mccolagan/colagan-pico-split-keyboard/hardware/images/usb-c-16p-brochage.png

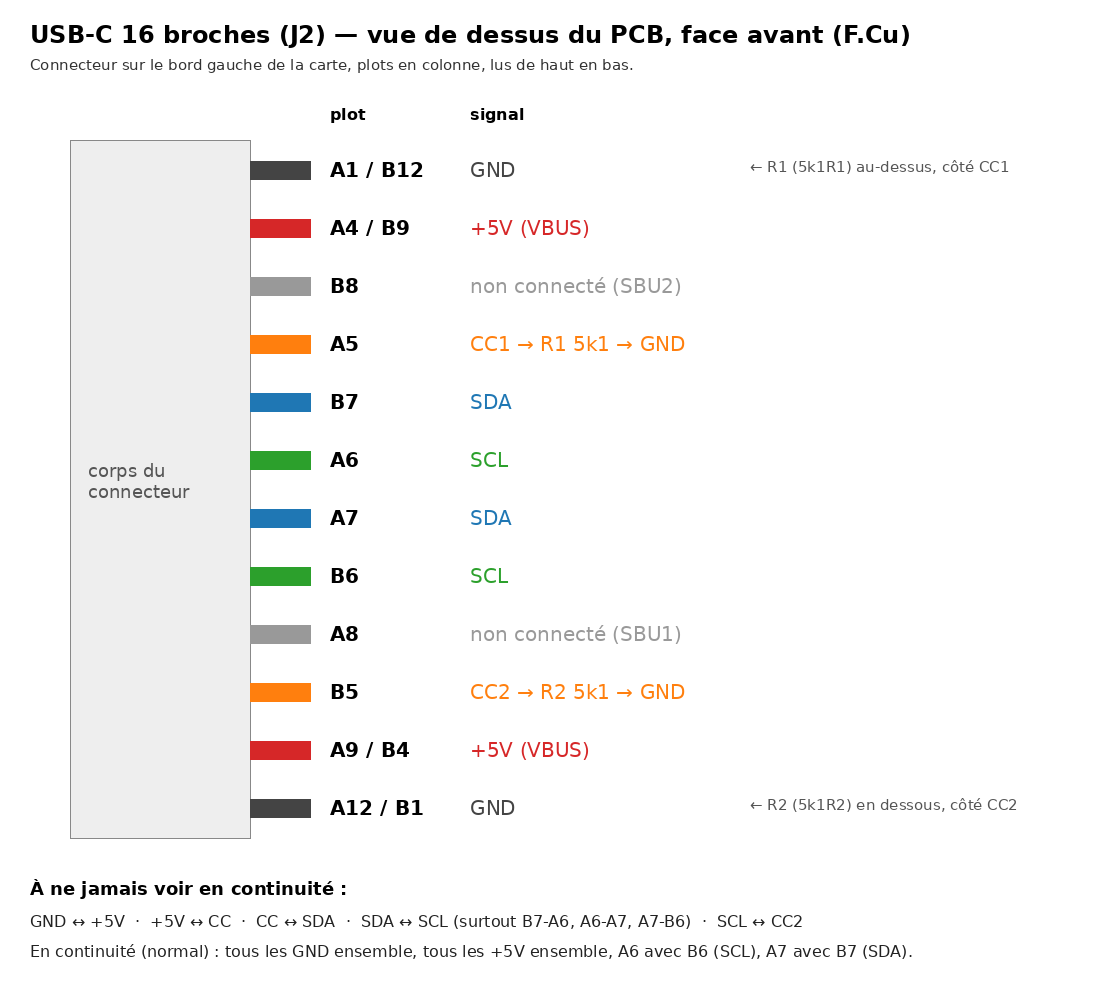
hardware/images/usb-c-16p-brochage.png
