mccolagan/colagan-pico-split-keyboard/hardware/3d/SPlitKeyBoardReversibleV1.step

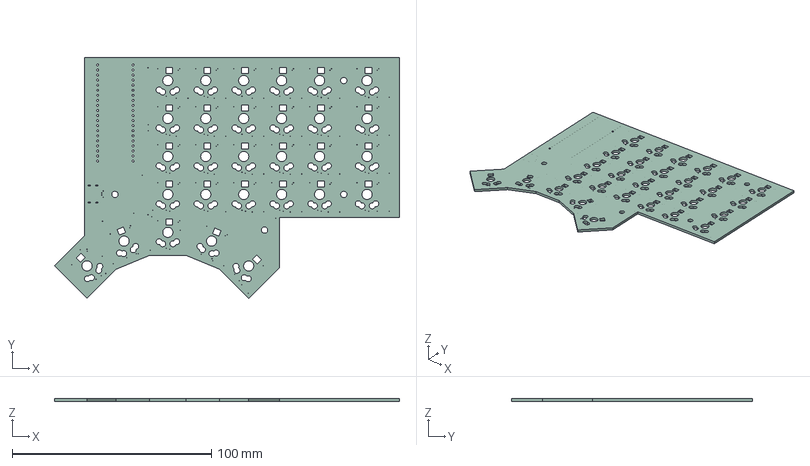
[picture p4: CAD file, 2026-10-23]
hardware/3d/SPlitKeyBoardReversibleV1.step
173.2 x 120.8 x 1.51 mm
