mccolagan/colagan-pico-split-keyboard/(list of files, cad)

Other CAD files:
hardware/3d/SPlitKeyBoardReversibleV1.3mf
