mccolagan/colagan-pico-split-keyboard/hardware/kicad/SplitKeyboard Colagan V2.kicad_pcb

## KiCad design hardware/kicad/SplitKeyboard Colagan V2.kicad_pcb (2026-10-25)

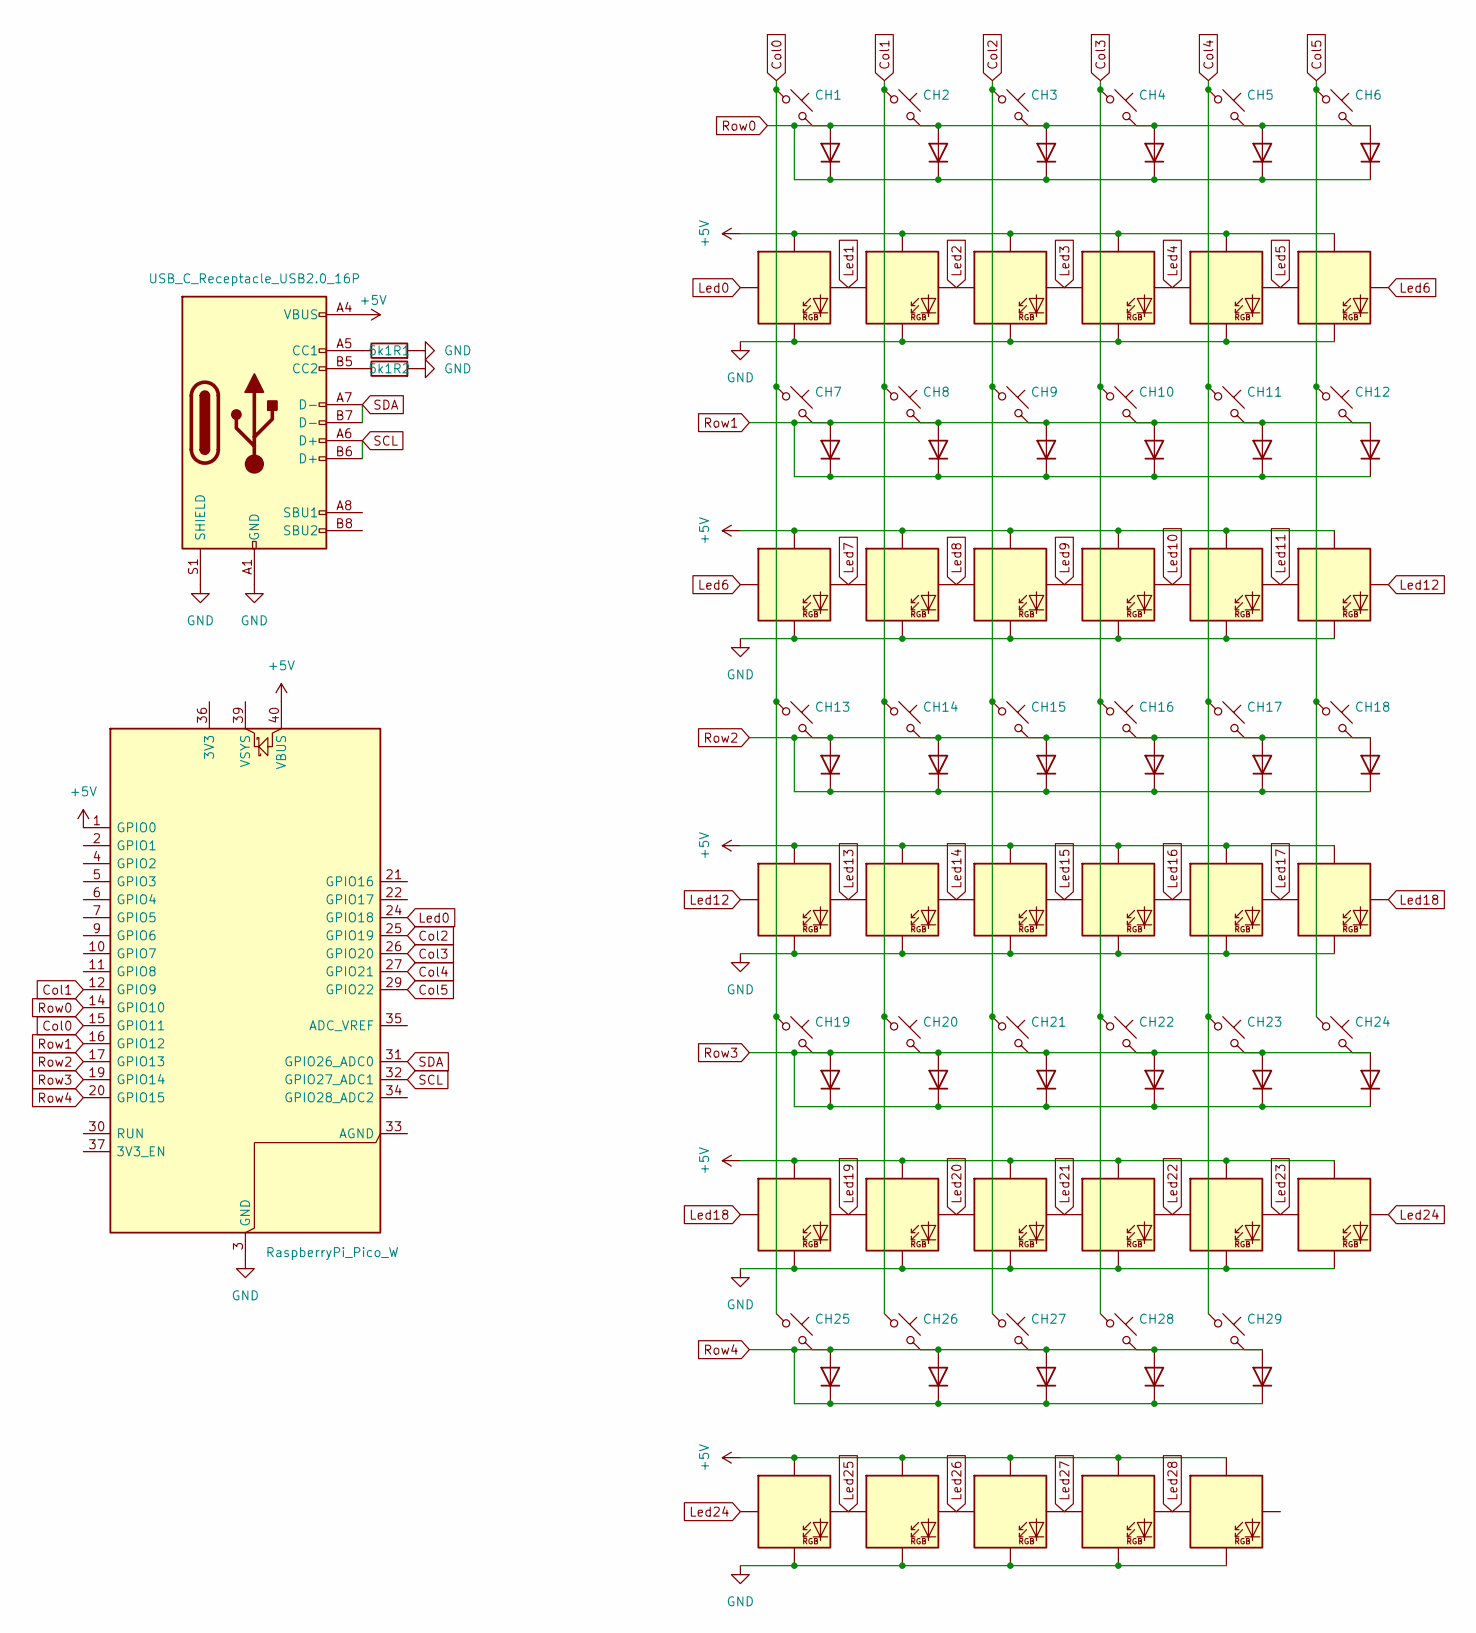
[picture p5: schematic SplitKeyboard Colagan V2.kicad_sch]

Parts:
5k1R1: R1; Capasitor_SMD_1206_Reversible_ColaganV3
5k1R2: Capasitor_SMD_1206_Reversible_ColaganV3
A1: RaspberryPi_Pico_W; RaspberryPi_Pico_Colagan_REF3
CH1, CH2, CH3, CH4, CH5, CH7, CH8, CH9, CH10, CH11, CH13, CH14, CH15, CH16, CH17, CH19, CH20, CH21, CH22, CH23, CH25, CH26, CH27, CH28, CH29: KS33_SW_HS; KS33-HS-Colagan-1U-Final
CH6, CH12, CH18, CH24: KS33_SW_HS; KS33-HS-Colagan-1.5U-Final
J2: USB_C_Receptacle_USB2.0_16P; USB_C_16P-Reversible-colagan

Connections:
+5V: A1.1 (GPIO0), A1.40 (VBUS), CH1.4 (VDD), CH2.4 (VDD), CH3.4 (VDD), CH4.4 (VDD), CH5.4 (VDD), CH6.4 (VDD), CH7.4 (VDD), CH8.4 (VDD), CH9.4 (VDD), CH10.4 (VDD), CH11.4 (VDD), CH12.4 (VDD), CH13.4 (VDD), CH14.4 (VDD), CH15.4 (VDD), CH16.4 (VDD), CH17.4 (VDD), CH18.4 (VDD), CH19.4 (VDD), CH20.4 (VDD), CH21.4 (VDD), CH22.4 (VDD), CH23.4 (VDD), CH24.4 (VDD), CH25.4 (VDD), CH26.4 (VDD), CH27.4 (VDD), CH28.4 (VDD), CH29.4 (VDD), J2.A4 (VBUS), J2.A9 (VBUS), J2.B4 (VBUS), J2.B9 (VBUS)
Col0: A1.15 (GPIO11), CH1.1, CH7.1, CH13.1, CH19.1, CH25.1
Col1: A1.12 (GPIO9), CH2.1, CH8.1, CH14.1, CH20.1, CH26.1
Col2: A1.25 (GPIO19), CH3.1, CH9.1, CH15.1, CH21.1, CH27.1
Col3: A1.26 (GPIO20), CH4.1, CH10.1, CH16.1, CH22.1, CH28.1
Col4: A1.27 (GPIO21), CH5.1, CH11.1, CH17.1, CH23.1, CH29.1
Col5: A1.29 (GPIO22), CH6.1, CH12.1, CH18.1, CH24.1
GND: 5k1R1.2, 5k1R2.2, A1.3 (GND), A1.8 (GND), A1.13 (GND), A1.18 (GND), A1.23 (GND), A1.28 (GND), A1.38 (GND), CH1.6 (VSS), CH2.6 (VSS), CH3.6 (VSS), CH4.6 (VSS), CH5.6 (VSS), CH6.6 (VSS), CH7.6 (VSS), CH8.6 (VSS), CH9.6 (VSS), CH10.6 (VSS), CH11.6 (VSS), CH12.6 (VSS), CH13.6 (VSS), CH14.6 (VSS), CH15.6 (VSS), CH16.6 (VSS), CH17.6 (VSS), CH18.6 (VSS), CH19.6 (VSS), CH20.6 (VSS), CH21.6 (VSS), CH22.6 (VSS), CH23.6 (VSS), CH24.6 (VSS), CH25.6 (VSS), CH26.6 (VSS), CH27.6 (VSS), CH28.6 (VSS), CH29.6 (VSS), J2.A1 (GND), J2.A12 (GND), J2.B1 (GND), J2.B12 (GND), J2.S1 (SHIELD)
Led0: A1.24 (GPIO18), CH1.5 (DIN)
Led1: CH1.7 (DOUT), CH2.5 (DIN)
Led2: CH2.7 (DOUT), CH3.5 (DIN)
Led3: CH3.7 (DOUT), CH4.5 (DIN)
Led4: CH4.7 (DOUT), CH5.5 (DIN)
Led5: CH5.7 (DOUT), CH6.5 (DIN)
Led6: CH6.7 (DOUT), CH7.5 (DIN)
Led7: CH7.7 (DOUT), CH8.5 (DIN)
Led8: CH8.7 (DOUT), CH9.5 (DIN)
Led9: CH9.7 (DOUT), CH10.5 (DIN)
Led10: CH10.7 (DOUT), CH11.5 (DIN)
Led11: CH11.7 (DOUT), CH12.5 (DIN)
Led12: CH12.7 (DOUT), CH13.5 (DIN)
Led13: CH13.7 (DOUT), CH14.5 (DIN)
Led14: CH14.7 (DOUT), CH15.5 (DIN)
Led15: CH15.7 (DOUT), CH16.5 (DIN)
Led16: CH16.7 (DOUT), CH17.5 (DIN)
Led17: CH17.7 (DOUT), CH18.5 (DIN)
Led18: CH18.7 (DOUT), CH19.5 (DIN)
Led19: CH19.7 (DOUT), CH20.5 (DIN)
Led20: CH20.7 (DOUT), CH21.5 (DIN)
Led21: CH21.7 (DOUT), CH22.5 (DIN)
Led22: CH22.7 (DOUT), CH23.5 (DIN)
Led23: CH23.7 (DOUT), CH24.5 (DIN)
Led24: CH24.7 (DOUT), CH25.5 (DIN)
Led25: CH25.7 (DOUT), CH26.5 (DIN)
Led26: CH26.7 (DOUT), CH27.5 (DIN)
Led27: CH27.7 (DOUT), CH28.5 (DIN)
Led28: CH28.7 (DOUT), CH29.5 (DIN)
unnamed: 5k1R1.1, J2.A5 (CC1)
unnamed: 5k1R2.1, J2.B5 (CC2)
Row0: A1.14 (GPIO10), CH1.2, CH1.3, CH2.2, CH2.3, CH3.2, CH3.3, CH4.2, CH4.3, CH5.2, CH5.3, CH6.2, CH6.3
Row1: A1.16 (GPIO12), CH7.2, CH7.3, CH8.2, CH8.3, CH9.2, CH9.3, CH10.2, CH10.3, CH11.2, CH11.3, CH12.2, CH12.3
Row2: A1.17 (GPIO13), CH13.2, CH13.3, CH14.2, CH14.3, CH15.2, CH15.3, CH16.2, CH16.3, CH17.2, CH17.3, CH18.2, CH18.3
Row3: A1.19 (GPIO14), CH19.2, CH19.3, CH20.2, CH20.3, CH21.2, CH21.3, CH22.2, CH22.3, CH23.2, CH23.3, CH24.2, CH24.3
Row4: A1.20 (GPIO15), CH25.2, CH25.3, CH26.2, CH26.3, CH27.2, CH27.3, CH28.2, CH28.3, CH29.2, CH29.3
SCL: A1.32 (GPIO27_ADC1), J2.A6 (D+), J2.B6 (D+)
SDA: A1.31 (GPIO26_ADC0), J2.A7 (D-), J2.B7 (D-)

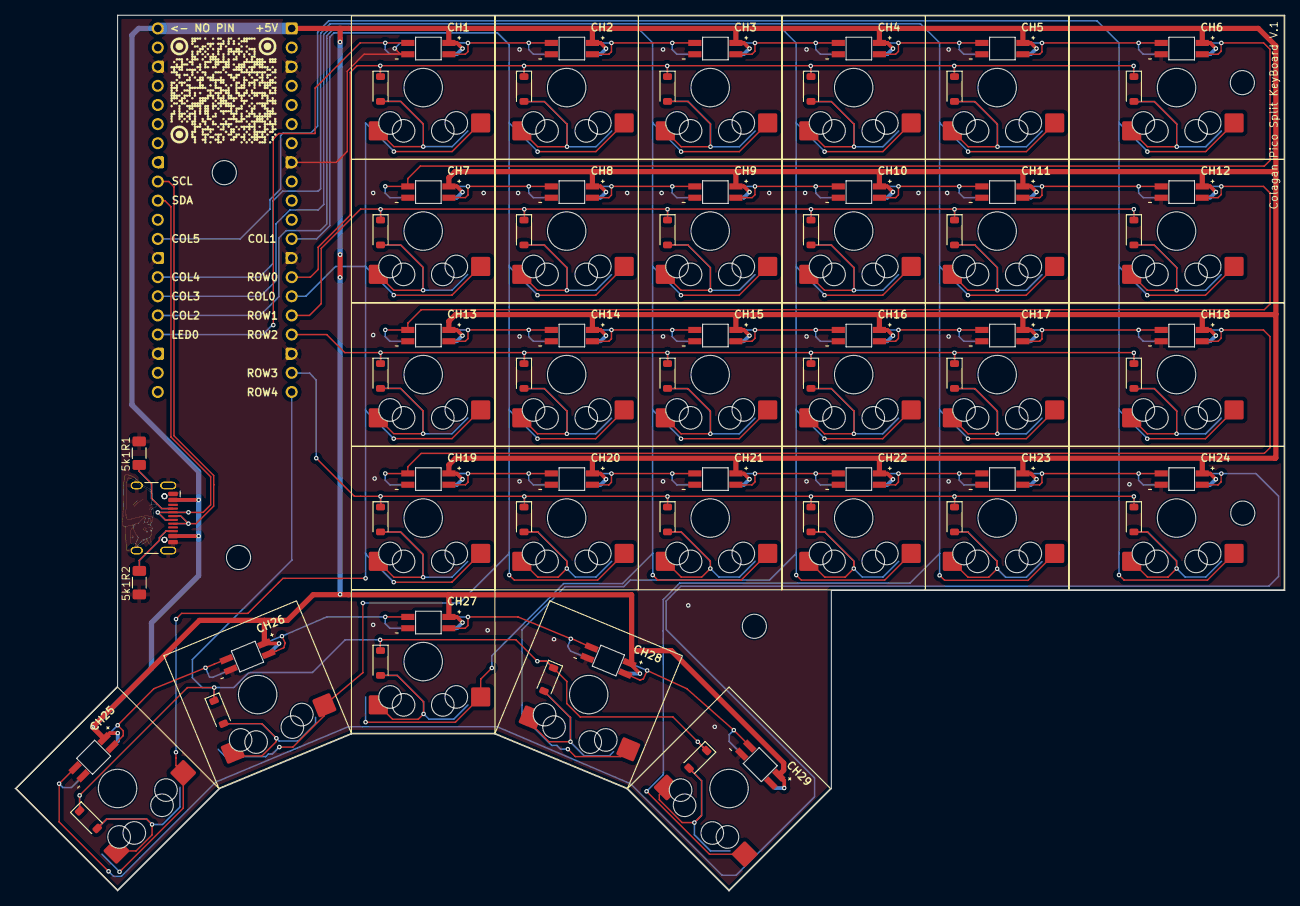
[picture p6: board SplitKeyboard Colagan V2.kicad_pcb from above]

Board: 2 copper layers, 168.5 x 116.3 mm, 33 parts (1 on the bottom side), 46 nets.
