mccolagan/colagan-pico-split-keyboard/(commit log)

2026-10-23 docs: align recap with the real PCB geometry and LED chain
2026-10-23 feat: add KiCad PCB sources, screenshots and 3D export
    [SPlitKeyBoardReversible.kicad_pcb, SPlitKeyBoardReversible.kicad_sch, SPlitKeyBoardReversibleOLED.kicad_pcb, SPlitKeyBoardReversibleV1.3mf, SPlitKeyBoardReversibleV1.step]
2026-10-23 docs: soften LED coordinate remark and list hardware folder
2026-10-23 docs: make KiCad project self-contained and document footprints
    Add library tables, extract the custom KS33 symbols from the schematic into
    Colagan.kicad_sym, and rewrite the hardware README (footprint inventory, 3D
    model status, electronics notes).
2026-10-24 feat: add split link test firmware for the two halves
    Serial half-duplex over PIO on GP26, same .uf2 for both halves.
    Status LED blinks on key press; bootmagic disabled to avoid
    accidental bootloader entry.
    [config.h, keymap.c]
2026-10-25 feat: add RGB matrix and per-half pin mapping to split test firmware
2026-10-25 docs: fix V2 hardware description and document left half assembly
2026-10-25 chore: replace hardware sources with the fabricated V2 PCB
    Archive the old 20/10/2025 revision outside the repo, add the V2 KiCad
    project and library, and regenerate the renders with kicad-cli.
    [SPlitKeyBoardReversible.kicad_pcb, SPlitKeyBoardReversibleOLED.kicad_pcb, SplitKeyboard Colagan V2.kicad_pcb, SplitKeyboard Colagan V2.kicad_sch]
2026-10-25 docs: point page comment to the V2 PCB file
2026-10-25 docs: rename the PCB render to bust the browser cache
2026-10-27 feat: add FPS and MMO gaming layers with layer selector
    Replace the single GAMING layer with Warzone (FPS) and WoW (MMO) layers
    sharing the same ZQSD cluster and menu keys. Add an MMO_UI sub-layer
    (F1-F5, game windows) and a SEL layer opened by triple-tap on Ctrl or by
    holding the thumb key in game layers. Widen the Ctrl multi-tap window to
    500 ms.
    [config.h, keymap.c]
2026-11-05 fix: make split test firmware reliable on slow USB hosts
    - Fix right half as master and left as slave instead of relying on USB
    enumeration timing (slow docks made the right half boot as slave)
    - Raise SPLIT_USB_TIMEOUT to 5 s and enable the split watchdog
    - Use GP27 as serial TX on the left half (USB-C mounted reversed,
    D+/D- crossed)
    - Turn the Pico status LED off 10 s after boot
    [config.h, keymap.c]
2026-11-05 docs: add USB-C 16-pin connector pinout diagram
2026-11-05 feat: add Vial firmware for the full split keyboard
    - Both halves (HALF_LEFT / HALF_RIGHT builds): mirrored matrix, LED and
    serial pins per half, USB-detected master with 5 s timeout and watchdog
    - Geometry generated from the KiCad switch positions (gen-layout.py):
    thumb arc, 1.5U outer column, mirrored left half, 58 keys and LEDs
    - Vial keymap with 8 layers (BASE, FN, FPS, MMO, MMO_UI, selector),
    VialRGB, bootmagic on each half, RGB brightness capped for USB power
    - Per-layer LED colour table (ledmaps) in keymap.c
    - Layer selector opened by 3 taps within 500 ms on the outer right thumb
    (SEL x3 custom keycode), unused selector keys preview the current effect
    - build-vial.sh compiles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
2026-11-05 feat: add read-only raw HID command to stream live LED colors
    Command 0xC0 returns protocol info, LED-to-matrix positions and the
    final color of all 58 LEDs (effect, per-layer ledmaps, brightness),
    read from the WS2812 driver buffer. LEDs of the slave half are fetched
    on demand through a split RPC. Includes the protocol spec for the web
    configurator and a stdlib-only Python test tool.
2026-11-05 docs: account for the CIE 1931 curve in LED stream display scaling
    RGB Matrix effects go through QMK's CIE 1931 lightness curve (val 64
    gives a PWM peak of 12) while per-layer ledmaps scale linearly. Document
    the exact formula and a hue-preserving normalisation for the configurator,
    and use it in the test tool.
2026-11-05 fix: apply the CIE 1931 curve to per-layer LED colors
    Effects go through QMK's lightness curve while ledmaps scaled linearly,
    making layer colors about 5x brighter than effects at the same setting
    (64 vs 12 at val 64). Scale ledmaps by the effect peak instead.
    [keymap.c]
2026-11-05 feat: store per-layer LED colors and effects in EEPROM
    Layer colors (58 RGB values + transparency mask per layer) and an
    optional per-layer RGB effect now live in the EEPROM keyboard datablock
    and are editable through new 0xC0 subcommands (protocol v2). The keymap
    ledmaps become first-boot defaults. The master pushes its colors to the
    slave half over split RPC and resyncs it after a reboot or missed write.
    A layer preview command lets the configurator show a layer on the
    keyboard without changing the typing layer; it expires after 3 s.
    The emulated EEPROM is doubled to keep room for Vial macros.
    [config.h, keymap.c]
2026-11-05 docs: document per-layer LED colors and the configurator protocol
2026-11-10 feat: update the MMO and MMO UI default binds and colors
    Match the real WoW Forever binds: turn left/right on the top row, dodges
    on the home row, action buttons 11-12 on ) and =, chat, targeting,
    combat and window keys on MMO UI, with LED colors per role.
    [keymap.c]
2026-11-10 docs: save the current layout export (WoW, 10/11/2026)
    Configurator .vil export of the keymap in use: hold the top-right key
    for the selector on BASE, FPS, MMO and MMO UI, Shift+1..5 and Ctrl+Tab on
    MMO, a Space/Down tap-dance, and TO(7) in the selector. It is newer than
    the keymap.c defaults.
